simondh/RMAC-Arduino/README.md

# RMAC-Arduino
Remote Monitoring And Control

Old, obsolete Arduino C++ code.
Delete eventually?
