simondh/RMAC-Arduino/Mechanical/VW drawings/RMAC 1.3 3d.pdf

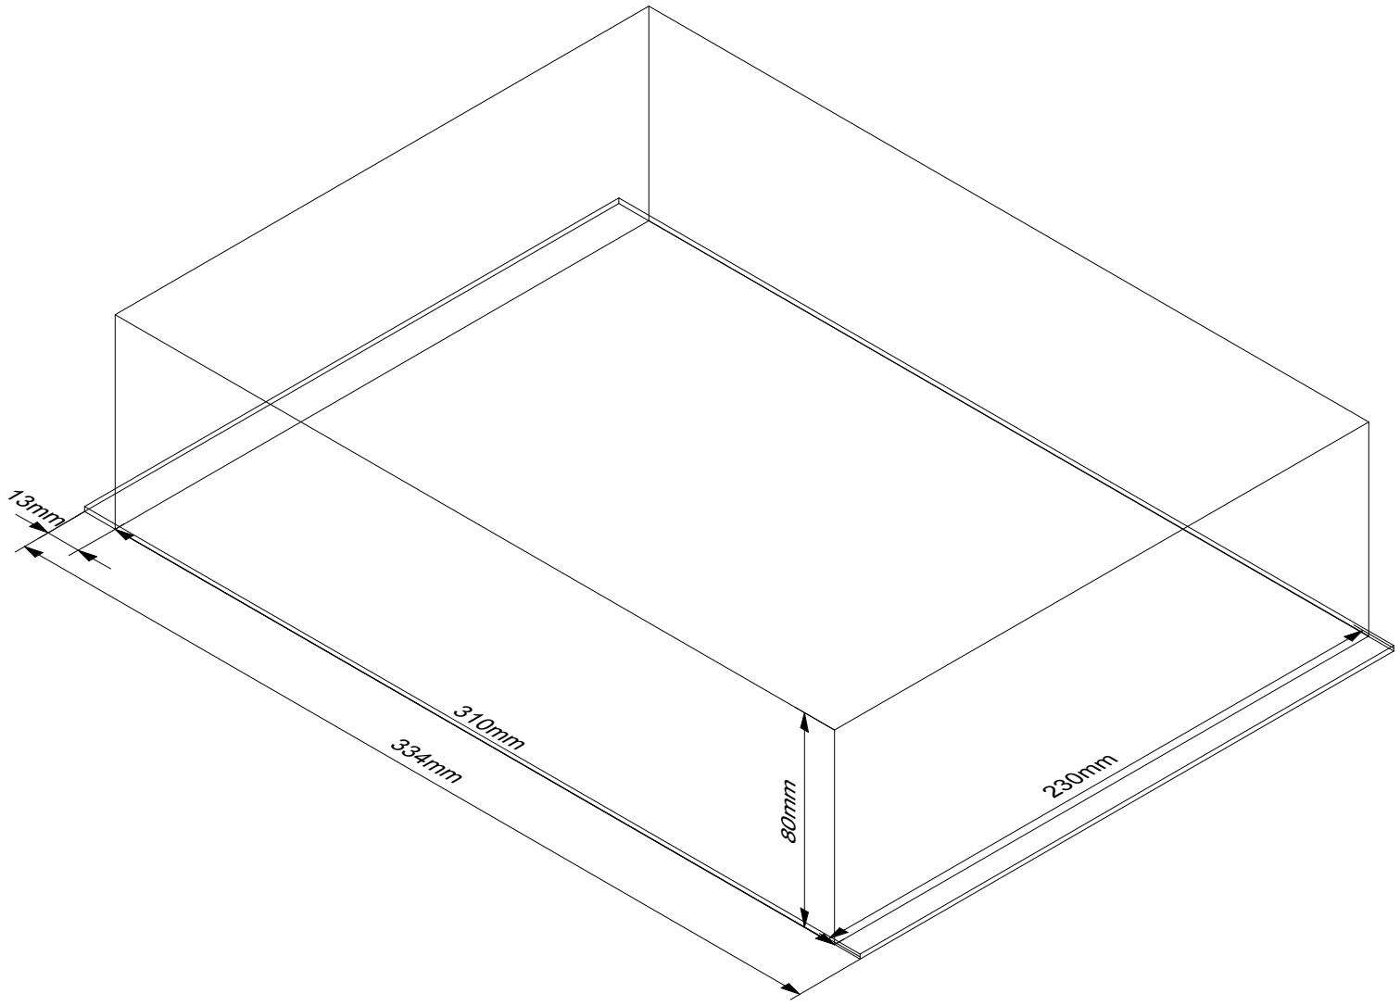
[picture p2: figure]
