simondh/RMAC-Arduino/Mechanical/partsList (from Simons MBP).xlsx

Sheet: Parts Ordered
Part | Currency | Amt | UKP | Supplier | link
Linkit One + relay shield |  |  | £161.93 | Cool Components | link
Relays, PIR, temp sensor, jumpers | US $ | $68.53 | £43.85 | Elecrow | link (http://www.elecrow.com/power-supply-c-68.html)
GSM cables | US $ |  |  | ChinaRF | link (http://www.ebay.com/usr/chinarf?_trksid=p2047675.l2559) | 4 u.fl - RP-SMA pigtails, 2 RP-SMA aerials, mag base
Cable glands |  |  |  | ? China
PSU 110v - 5v |  |  |  | RS
case, screws |  |  | £31.31 | RS

Sheet: parts list
Bill of Materials
Part # | Description | Eagle part no | Qty | Supplier | Supplier ref | Each | Total | Pack size | Unit cost | priced-each pack size | How many RMACs | Full description | Alternatiove
1 | Steel enclosure |  | 1 | RS | 232-002 | £22.73 | £22.73 | 1 | £22.73 |  |  | Grey 1.2mm mild steel case,310x230x80mm
1a | steel enclosure, alt |  | 1 | RS
2 | IEC socket |  | 1 | RS | 815-830 (http://uk.rs-online.com/web/p/iec-connectors/0815830/) | £2.18 | £2.18 | 1 | £2.18
2 | Fuse 1A slow blow 20X5mm |  | 2 | RS | 789-7797 | £0.11 | £0.22 | 1 | £0.22 |  |  | pack of 10
3 | IEC plug, free |  | 1 | RS | 488-905 | £2.27 | £2.27 | 1 | £2.27
4 | EDAC 38 cable receptacle |  | 1 | RS | 476-429 (http://uk.rs-online.com/web/p/general-purpose-rectangular-connectors/0476429/) | £6.40 | £6.40 | 1 | £6.40
5 | EDAC 38 plug |  | 1 | RS | 476-413 (http://uk.rs-online.com/web/p/general-purpose-rectangular-connectors/0476413/) | £9.73 | £9.73 | 1 | £9.73
6 | EDAC 38 cover |  | 1 | RS | 476-463 (http://uk.rs-online.com/web/p/backplane-accessories/0476463/) | £10.02 | £10.02 | 1 | £10.02
7 | EDAC solder terminals |  | 1 | RS | 476-485 | £22.88 | £22.88 | 1 | £22.88 |  |  | (Pack 100, will make 1.3 RMACs) | 476-491 crimp £17.83
8 | RP-SMA to mag base aerial, GSM |  | 1 | ChinaRF
 | u.fl to RP-SMA bulkhead |  | 1 | ChinaRF
8 | 0.1" pin headers 10 way |  | 1 | RS | 673-7486 | £0.24 | £0.24 | 1 | £0.24 | 5 | 5 | 26way IDC to Linkit
9 | 0.1" pin headers 8 way |  | 1 | RS | 132-0428 | £0.21 | £0.21 | 1 | £0.21 | 10 | 10 | 26way IDC to Linkit
10 | 0.1" pin headers 6 way |  | 3 | RS | 745-7062 | £0.18 | £0.54 | 1 | £0.54 | 10 | 3.333333333
 | 0.1" pin headers 6 way right0-angle |  | 1 | RS | 679-5473 | £0.10 | £0.10 | 1 | £0.10 | 10 | 10
11 | 0.1" pin headers 4 way | 4WAY3 | 1 | RS | 546-8899 | £12.80 | £12.80 | 1 | £12.80 | 10 | 10
12 | 0.1" pin headers 3 way |  | 1 | RS | 820-1431 | £0.10 | £0.10 | 1 | £0.10 | 5 | 5
12 | 0.1" pin headers 3 way | 3-WAY-1 | 1 | RS | 820-1431 | £0.10 | £0.10 | 1 | £0.10 | 5 | 5
13 | 26 way IDC plug | JP1 | 2 | RS | 471-064 | £0.66 | £1.32 | 1 | £1.32
14 | 26 way IDC socket |  | 2 | RS | 471-222 | £0.40 | £0.80 | 1 | £0.80
15 | 0.1" crimp sockets |  | 1 | RS | 467-598 | £6.00 | £6.00 | 1 | £6.00 |  |  | 100 per pack, 1 pack per RMAC
16 | 10W 5V dc, 2000mA |  | 1 | RS | 665-5710 | £37.50 | £37.50 | 1 | £37.50
17 | PCF8574A I2C 8-bit expander 0111,DIP16 |  | 2 | RS | 517-0249 | £1.33 | £2.66 | 1 | £2.66
18 | CNY74A quad optocoupler DIL 16 |  | 2 | RS | 699-8170 | £0.84 | £1.68 | 1 | £1.68 | 5 | 2.5
 | 15kΩ single R | R18, R20 | 2 | RS | 683-2737 (http://uk.rs-online.com/web/p/through-hole-fixed-resistors/6832737/) | £0.04 | £0.09 | 1 | £0.09 | 25 |  | RS don’t have any small low cost axial. Get in 1210?
 | 270kΩ | R22 | 1 | RS | 683-2799 | £0.06 | £0.06 | 1 | £0.06 | 25
 | 10kΩ 8 R bus (9 pin) | RN1 | 1 | RS | 788-4094 | £0.36 | £0.36 | 1 | £0.36 | 5 | 5
 | Isolated Resistor Array 10k½ ±2% 3 Resistors | RN5, RN6 | 2 | RS | 522-3602 | £0.07 | £0.14 | 1 | £0.14 | 25 | 12 | Try 691-7437 7 X 10kΩ SMD
 | Isolated Resistor Array 220½ ±2% 4 Resistors, SIP Package | RN4 | 1 | RS | 522-3882 | £0.04 | £0.04 | 1 | £0.04 | 25 | 25
 |  |  |  |  |  |  | £0.00 | 1 | £0.00
20 | Isolated Resistor Array 330Ω 4 Resistors, SIP Package | RN7, RN8 | 2 | RS | 522-3961 | £0.10 | £0.20 | 25 | £0.01 | 25 | 12
21 | Isolated Resistor Array 1kΩ 4 Resistors, SIP Package |  | 2 | RS | 522-3804 | £0.17 | £0.33 | 1 | £0.33 | 25 | 12
22 | Diode, Schottky Barrier 2A max, 60V, 2-Pin, DO-204AC |  | 2 | RS | 812-9326 | £0.13 | £0.27 | 1 | £0.27 | 20 | 10
23 | Zener diodes, 5.1V |  | 3 | RS | 708-7938 | £0.05 | £0.16 | 1 | £0.16 | 100 | 33.33333333
 | Modules
24 | RS485 daughter board |  | 1 | Elecrow |  |  | £0.00 |  | #DIV/0!
25 | Linkit One |  | 1 | Cool Components |  |  | £0.00 |  | #DIV/0!
25 | 4 relay board |  | 1 | Elecrow |  |  | £0.00 |  | #DIV/0!
25 | Temp & Humidity |  | 1 | Elecrow | EBR00081T | £3.19 |  | 1 | £3.19
26 | Finger Guard 60mm Steel |  | 1 | RS | 737-3973 | £0.84 | £0.84 | 1 | £0.84 | 10 | 10
27 | 0.1uf cap (100nf) |  | 6 | RS | 537-3707 | £0.15 | £0.88 | 1 | £0.88 | 25 | 4.166666667
28 | Equipment wire |  | - | RS | 361-721 | £17.29 | £0.35 | 1 | #VALUE! | 100m | 50
29 |  |  |  |  |  |  | £0.00 |  | #DIV/0!
30 | Front Panel: |  |  |  |  |  | £0.00 |  | #DIV/0!
31 | PIR |  | 1 | Elecrow | SOD00101S | £1.27 | £1.27 | 1 | £1.27
32 | LED Red |  | 1 | RS | 228-5988 |  | £0.07 | 1 | £0.00 | 5 | 5
33 | LED Green |  | 1 | RS | 646-6658 (http://uk.rs-online.com/web/p/visible-leds/6466658/) |  | £0.05 | 1 |  | 20 | 20
34 | LED Blue |  | 1 | RS | 466-3548 |  | £0.35 | 1 |  | 5 | 5
35
36 | Panels:
37 | Neutrik USB Panel Mount Socket |  | 1 | Maplin | N57FL | £5.29 | £5.29 | 1
38 | XLR Connector |  | 1 | RS | 455-104 | £1.27
39 | Male Straight Cable Mount XLR |  | 1 | RS | 455-122 | £1.95
 | M3 X 6 |  |  | RS | 560-580 | £2.05 |  |  |  | bag 100
 | M3 nylon nut |  |  | RS | 525-701 | £2.89 |  |  |  | bag 50
 | M3 self tap |  |  | RS | 483-1202 | £3.39 |  |  |  | bag 100 |  | Use for XLT socket!
 | M3 nylon washer |  |  | RS | 525-739 (http://uk.rs-online.com/web/p/sealing-washers/0525739/) | £1.63 |  |  |  | bag 50
 | M3 X M3 10mm nylon standoff |  |  | RS | 325-687 | £0.17 |  |  |  | bag 50
 | 10 way 7/0.15 PVC ribbon cable,10m |  |  | RS | 214-0661
 | stick on cable tie pads
 | tie wraps

Sheet: ConversionRate
GBP | US $ | 1.563

Sheet: Pins and design
Linkit One - logical |  |  |  |  |  |  |  |  |  |  | Linkit One - physical
Logical |  | Physical | Linkit use |  | DNO design use | Device | input/output | Alt | Main |  |  |  |  | Main | Alt
D0 | 8W-1-1 | 1 | Tx | Led | (Program uploader) |  | Input |  | N/A | 8w-2-1 | 19 | 18 | 10w-10 | D18 | SCL (NA)
D1 | 8W-1-2 | 2 | Rx | Led | (Program uploader) |  | Input |  | IOREF | 8w-2-2 | 20 | 17 | 10w-9 | D19 | SDA (NA)
D2 | 8W-1-3 | 3 | Eint |  | power fail |  | Input |  | RESET | 8w-2-3 | 21 | 16 | 10w-8 | N/A
D3 | 8W-1-4 | 4 | Eint / PWM |  | DigitalAlarm 1 |  |  |  | 3V3 | 8w-2-4 | 22 | 15 | 10w-7 | GND
D4 | 8W-1-5 | 5 |  |  | DigitalAlarm 2 |  | Input |  | 5V | 8w-2-5 | 23 | 14 | 10w-6 | D13 | (Internal LED)/spare
D5 | 8W-1-6 | 6 |  |  | DigitalAlarm 3 |  | Input |  | GND | 8w-2-6 | 24 | 13 | 10w-5 | D12 | 1WI Temperature
D6 | 8W-1-7 | 7 |  |  | DigitalAlarm 4 |  | Input |  | GND | 8w-2-7 | 25 | 12 | 10w-4 | D11 | PIR
D7 | 8W-1-8 | 8 |  |  | DigitalAlarm 5 |  | Input |  | N/A | 8w-2-8 | 26 | 11 | 10w-3 | D10 | DigitalAlarm 8
D8 | 10w-1 | 9 |  |  | DigitalAlarm 6 |  | Input | analog1 | ADC0 | 6w-1 | 27 | 10 | 10w-2 | D9 | DigitalAlarm 7
D9 | 10w-2 | 10 | PWM |  | DigitalAlarm 7 |  |  | analog2 | ADC1 | 6w-2 | 28 | 9 | 10w-1 | D8 | DigitalAlarm 6
D10 | 10w-3 | 11 |  |  | DigitalAlarm 8 |  | Input | analog3 | ADC2 | 6w-3 | 29 | 8 | 8w-1-8 | D7 | DigitalAlarm 5
D11 | 10w-4 | 12 | MOSI |  | PIR |  |  |  | ADC3 | 6w-4 | 30 | 7 | 8w-1-7 | D6 | DigitalAlarm 4
D12 | 10w-5 | 13 | MISO |  | 1WI for temp & humidity |  |  | SCL | D18 | 6w-5 | 31 | 6 | 8w-1-6 | D5 | DigitalAlarm 3
D13 | 10w-6 | 14 | SCK | Led |  |  |  | SDA | D19 | 6w-6 | 32 | 5 | 8w-1-5 | D4 | DigitalAlarm 2
 |  |  |  |  |  |  |  |  |  |  |  | 4 | 8w-1-4 | D3 | DigitalAlarm 1
 |  |  |  |  |  |  |  | PCF8574AN expander | GND |  | 4 Way 1-1 | 3 | 8w-1-3 | D2 | power fail
 |  |  |  |  |  |  |  |  | 5V |  | 4 Way 1-2 | 2 | 8w-1-2 | TX | D1
 |  |  |  |  |  |  |  |  | SDA |  | 4 Way 1-3 | 1 | 8w-1-1 | RX | D0
D18 | 10w-9 | 17 | SDA |  | Signal expander | PCF8574AN | I/O |  | SCL |  | 4 Way 1-4
D19 | 10w-10 | 18 | SCL |  | Signal expander | PCF8574AN | I/O
ADC0 | 6w-1-1 | 27 |  |  | 20 ma 1 |  | Input
ADC1 | 6w-1-2 | 28 |  |  | 20 ma 2 |  | Input
ADC2 | 6w-1-3 | 29 |  |  | 20 ma 3 |  | Input
GND |  | PWR 1 |  | USB | To Panel USB socket
5 |  | PWR 2 |  | GSM Aerial | To Panel aerial socket
 |  |  |  |  |  |  |  | MOTHERBOARD
4-way-1-1 | GND | PCF8574AN expander |  |  |  |  |  | Plug & Pin | Purpose | To | To (B-end) | route to (on motherboard)
4-way-1-2 | 5V
4-way-1-3 | SDA
4-way-1-4 | SCL
 |  |  |  |  |  |  |  | 4-way-3-1 | GND | Linkit 4-way-1 |  | gnd | 'Bottom' of board nearest LinkIt logo
PCF8574AN expander |  |  |  |  |  |  |  | 4-way-3-2 | 5V |  |  | 5v | Connects to PCF8574AN expander
Logical | Physical | Connector | Purpose |  |  |  |  | 4-way-3-3 | SDA |  |  | PCF 14
A0 | 1 |  | 0v |  |  |  |  | 4-way-3-4 | SCL |  |  | PCF 15
A1 | 2 |  | 0v
A2 | 3 |  | 0v |  |  |  |  | 6-way-2-1 | 0v | 6-way-5 relay board |  | gnd
P0 | 4 | 6-way-2-2 | Relay 1 |  |  |  |  | 6-way-2-2 | relay 1 |  |  | PCF 4 (P0)
P1 | 5 | 6-way-2-3 | Relay 2 |  |  |  |  | 6-way-2-3 | relay 2 |  |  | PCF 5 (P1)
P2 | 6 | 6-way-2-4 | Relay 3 |  |  |  |  | 6-way-2-4 | relay 3 |  |  | PCF 6 (p2)
P3 | 7 | 6-way-2-5 | Relay 4 |  |  |  |  | 6-way-2-5 | relay 4 |  |  | PCF 7 (P3)
GND | 8 |  | 0v |  |  |  |  | 6-way-2-6 | 5v |  |  | 5v
P4 | 9 | 6-way-3-3 | Fault LED (Red)
P5 | 10 | 6-way-3-5 | Green LED |  |  |  |  | 6-way-3-1 | 0v | Front Panel | PIR 3 |  | Also LED -ve (cathode)
P6 | 11 | 6-way-3-5 | Transmission OK LED (Blue) |  |  |  |  | 6-way-3-2 | PIR detect |  | PIR 2
P7 | 12 |  | spare |  |  |  |  | 6-way-3-3 | Red LED + |  |  | PCF9 (P4) | Anode (+ve) long wire
~INT | 13 |  | (output, ignore) |  |  |  |  | 6-way-3-4 | Green LED + |  |  | PCF10 (P5) | Cathode (-ve) short wire
SCL | 14 | 4-way-3-4 | SCL |  |  |  |  | 6-way-3-5 | Blue LED + |  |  | PCF11 (P6)
SDA | 15 | 4-way-3-3 | SDA |  |  |  |  | 6-way-3-6 | 5v |  | PIR 1
Vcc | 16 |  | 5V
 |  |  |  |  |  |  |  | 6-way-4-1 | ADC0 | Linkit 6-way-1 | 6w-1 | Analogue resistors
 |  |  |  |  |  |  |  | 6-way-4-2 | ADC1 |  | 6w-2
 |  |  |  |  |  |  |  | 6-way-4-3 | ADC2 |  | 6w-3
 |  |  |  |  |  |  |  | 6-way-4-4 | na |  | 6w-4
 |  |  |  |  |  |  |  | 6-way-4-5 | na
EDAC 38 way |  |  |  |  | Relay Board |  |  | 6-way-4-6 | na
Pin | Pin Code |  |  |  | Logical | Physical | Connector
1 | A | Relay 1 NC | screw-1 |  | 0v | 6-way-5-1 | mother 0v | 3-way-1 | gnd | Temp & Humidity
2 | B | Relay 1 common | screw-2 |  | relay 1 | 6-way-5-2 | PCF pin 4 | 3-way-2 | 5v
3 | C | relay 1 NO | screw-3 |  | relay 2 | 6-way-5-3 | PCF pin 5 | 3-way-3 | sig |  |  | 10way1-5
4 | D | Relay 2 NC | screw-4 |  | relay 3 | 6-way-5-4 | PCF pin 6
5 | E | Relay 2 common | screw-5 |  | relay 4 | 6-way-5-5 | PCF pin 7 | 10-way-2-1 | DigitalAlarm 6 | Linkit 10-way | CNY74-2-14
6 | F | relay 2 NO | screw-6 |  | 5V | 6-way-5-6 | mother 5v | 10-way-2-2 | DigitalAlarm 7 |  | CNY74-2-11
7 | H | Relay 3 NC | screw-7 |  | Relay 1 NC | screw-1 | EDAC A | 10-way-2-3 | DigitalAlarm 8 |  | CNY74-2-10
8 | J | Relay 3 common | screw-8 |  | Relay 1 common | screw-2 | EDAC B | 10-way-2-4 | PIR |  | 6-way-3-2
9 | K | relay 3 NO | screw-9 |  | relay 1 NO | screw-3 | EDAC C | 10-way-2-5 | 1WI Temperature |  | 3-way-3
10 | L | Relay 4 NC | screw-10 |  | Relay 2 NC | screw-4 | EDAC D | 10-way-2-6 | D13 |  | RS485 driver
11 | M | Relay 4 common | screw-11 |  | Relay 2 common | screw-5 | EDAC E | 10-way-2-7 | na
12 | N | relay 4 NO | screw-12 |  | relay 2 NO | screw-6 | EDAC F | 10-way-2-8 | na
13 | P | (spare) |  |  | Relay 3 NC | screw-7 | EDAC H | 10-way-2-9 | na
14 | R | (spare) |  |  | Relay 3 common | screw-8 | EDAC J | 10-way-2-10 | na
15 | S | (spare) |  |  | relay 3 NO | screw-9 | EDAC K
16 | T | (spare) |  |  | Relay 4 NC | screw-10 | EDAC L | 8-way-7-1 | na | Linkit 8-way-1
17 | U | DigAlarm 1 A | 1 |  | Relay 4 common | screw-11 | EDAC M | 8-way-7-2 | na
18 | V | DigAlarm 1 B | 2 |  | relay 4 NO | screw-12 | EDAC N | 8-way-7-3 | power fail |  |  | PSU before diodes
19 | W | DigAlarm 2 A | 3 |  |  |  |  | 8-way-7-4 | DigitalAlarm1 |  | CNY74-1-15
20 | X | DigAlarm 2 B | 4 |  |  |  |  | 8-way-7-5 | DigitalAlarm2 |  | CNY74-1-14
21 | Y | DigAlarm 3 A | 5 |  |  |  |  | 8-way-7-6 | DigitalAlarm3 |  | CNY74-1-11
22 | Z | DigAlarm 3 B | 6 |  |  |  |  | 8-way-7-7 | DigitalAlarm4 |  | CNY74-1-10
23 | AA | DigAlarm 4 A | 7 |  |  |  |  | 8-way-7-8 | DigitalAlarm5 |  | CNY74-2-15
24 | BB | DigAlarm 4 B | 8
25 | CC | DigAlarm 5 A | 9 |  |  |  |  | 26-w-1 | DigAlarm 1 A | U | CNY74 resistors | +5v B
26 | DD | DigAlarm 5 B | 10 |  |  |  |  | 26-w-2 | DigAlarm 1 B | V |  | 330Ω R9 | CNY74-1-1
27 | EE | DigAlarm 6 A | 11 |  |  |  |  | 26-w-3 | DigAlarm 2 A | W |  | +5v B
28 | FF | DigAlarm 6 B | 12 |  |  |  |  | 26-w-4 | DigAlarm 2 B | X |  | 330Ω R10 | CNY74-1-4
29 | HH | DigAlarm 7 A | 13 |  |  |  |  | 26-w-5 | DigAlarm 3 A | Y |  | +5v B
30 | JJ | DigAlarm 7 B | 14 |  |  |  |  | 26-w-6 | DigAlarm 3 B | Z |  | 330Ω R11 | CNY74-1-5
31 | KK | DigAlarm 8 A | 15 |  |  |  |  | 26-w-7 | DigAlarm 4 A | AA |  | +5v B
32 | LL | DigAlarm 8 B | 16 |  |  |  |  | 26-w-8 | DigAlarm 4 B | BB |  | 330Ω R12 | CNY74-1-8
33 | MM | Analog 1 0v | 17 |  |  |  |  | 26-w-9 | DigAlarm 5 A | CC |  | +5v B
34 | NN | Analog 1 12v | 18 |  |  |  |  | 26-w-10 | DigAlarm 5 B | DD |  | 330Ω R13 | CNY74-2-1
35 | PP | Analog 2 0v | 19
36 | RR | Analog 2 12v | 20 |  |  |  |  | 26-w-11 | DigAlarm 6 A | EE |  | +5v B
37 | SS | Analog 3 0v | 21 |  |  |  |  | 26-w-12 | DigAlarm 6 B | FF |  | 330Ω R14 | CNY74-2-4
38 | TT | Analog 3 12v | 22 |  |  |  |  | 26-w-13 | DigAlarm 7 A | HH |  | +5v B
Yes the letters are NOT in sequence! |  |  |  |  |  |  |  | 26-w-14 | DigAlarm 7 B | JJ |  | 330Ω R15 | CNY74-2-5
 |  |  |  |  |  |  |  | 26-w-15 | DigAlarm 8 A | KK |  | +5v B
 |  |  |  |  |  |  |  | 26-w-16 | DigAlarm 8 B | LL |  | 330Ω R16 | CNY74-2-8
 |  |  |  |  |  |  |  | 26-w-17 | Analog 1 0v | MM | Dividing resistors | GND
Socket Summary |  |  |  |  |  |  |  | 26-w-18 | Analog 1 12v | NN |  | 14kΩ R20
Motherboard | Other end |  |  |  |  |  |  | 26-w-19 | Analog 2 0v | PP |  | GND
2-way-1 | Mains input |  |  |  |  |  |  | 26-w-20 | Analog 2 12v | RR |  | 14kΩ R18
2-way-2 | RS485
3-way-1 | Temp & Humidity |  |  |  |  |  |  | 26-w-21 | Analog 3 0v | SS | Dividing resistors | GND
6-way-2 | Relay board |  |  |  |  |  |  | 26-w-22 | Analog 3 110v | TT |  | 270kΩ R22
6-way-3 | Front cover |  |  |  |  |  |  | 26-w-23 | spare | P
6-way-4 | LinkIt 6-way |  |  |  |  |  |  | 26-w-24 | spare | R
4-way-1 | Linkit SCL/SDA 4-way |  |  |  |  |  |  | 26-w-25 | spare | S
8-way-1 | Linkit 8-way-1 |  |  |  |  |  |  | 26-w-26 | spare | T
10-way-1 | Linkit 10-way
26-way | EDAC 38 way
 | Point sizes for drawing cables
 | 3 | 2.25
 | 4 | 3
 | 5 | 3.75
 | 6 | 4.5
 | 8 | 6
 | 10 | 7.5
 | 12 | 9

Sheet: Pin Design V2
Linkit One - logical |  |  |  |  |  |  |  |  |  |  |  | Linkit One - physical
Logical |  | Physical | Linkit use |  | DNO design use | Device | input/output | Alt |  | Main |  |  |  |  | Main | Alt
D0 | 8W-1-1 | 1 | Tx | Led | (Program uploader) |  | Input |  |  | N/A | 8w-2-1 | 19 | 18 | 10w-10 | D18 | SCL (NA)
D1 | 8W-1-2 | 2 | Rx | Led | (Program uploader) |  | Input |  |  | IOREF | 8w-2-2 | 20 | 17 | 10w-9 | D19 | SDA (NA)
D2 | 8W-1-3 | 3 | Eint |  | power fail |  | Input |  |  | RESET | 8w-2-3 | 21 | 16 | 10w-8 | N/A
D3 | 8W-1-4 | 4 | Eint / PWM |  | DigitalAlarm 1 |  |  |  |  | 3V3 | 8w-2-4 | 22 | 15 | 10w-7 | GND
D4 | 8W-1-5 | 5 |  |  | DigitalAlarm 2 |  | Input |  |  | 5V | 8w-2-5 | 23 | 14 | 10w-6 | D13 | (Internal LED)/spare
D5 | 8W-1-6 | 6 |  |  | DigitalAlarm 3 |  | Input |  |  | GND | 8w-2-6 | 24 | 13 | 10w-5 | D12 | 1WI Temperature
D6 | 8W-1-7 | 7 |  |  | DigitalAlarm 4 |  | Input |  |  | GND | 8w-2-7 | 25 | 12 | 10w-4 | D11 | PIR
D7 | 8W-1-8 | 8 |  |  | DigitalAlarm 5 |  | Input |  |  | N/A | 8w-2-8 | 26 | 11 | 10w-3 | D10 | self test (Active LOW - tun on pull up R!)
D8 | 10w-1 | 9 |  |  | DigitalAlarm 6 |  | Input | analog1 |  | ADC0 | 6w-1 | 27 | 10 | 10w-2 | D9
D9 | 10w-2 | 10 | PWM |  | DigitalAlarm 7 |  |  | analog2 |  | ADC1 | 6w-2 | 28 | 9 | 10w-1 | D8
D10 | 10w-3 | 11 |  |  | DigitalAlarm 8 |  | Input | analog3 |  | ADC2 | 6w-3 | 29 | 8 | 8w-1-8 | D7
D11 | 10w-4 | 12 | MOSI |  | PIR |  |  |  |  | ADC3 | 6w-4 | 30 | 7 | 8w-1-7 | D6 | RS485 RO
D12 | 10w-5 | 13 | MISO |  | 1WI for temp & humidity |  |  | SCL |  | D18 | 6w-5 | 31 | 6 | 8w-1-6 | D5 | RS485 DI
D13 | 10w-6 | 14 | SCK | Led |  |  |  | SDA |  | D19 | 6w-6 | 32 | 5 | 8w-1-5 | D4 | RS485 DE
 |  |  |  |  |  |  |  |  |  |  |  |  | 4 | 8w-1-4 | D3 | RS485 RE
 |  |  |  |  |  |  |  | PCF8574AN expander |  | GND |  | 4 Way 1-1 | 3 | 8w-1-3 | D2 | power fail
 |  |  |  |  |  |  |  |  |  | 5V |  | 4 Way 1-2 | 2 | 8w-1-2 | TX | D1
 |  |  |  |  |  |  |  |  |  | SDA |  | 4 Way 1-3 | 1 | 8w-1-1 | RX | D0
D18 | 10w-9 | 17 | SDA |  | Signal expander | PCF8574AN | I/O |  |  | SCL |  | 4 Way 1-4
D19 | 10w-10 | 18 | SCL |  | Signal expander | PCF8574AN | I/O
ADC0 | 6w-1-1 | 27 |  |  | 20 ma 1 |  | Input
ADC1 | 6w-1-2 | 28 |  |  | 20 ma 2 |  | Input
ADC2 | 6w-1-3 | 29 |  |  | 20 ma 3 |  | Input
GND |  | PWR 1 |  | USB | To Panel USB socket
5 |  | PWR 2 |  | GSM Aerial | To Panel aerial socket
 |  |  |  |  |  |  |  | MOTHERBOARD
4-way-1-1 | GND | PCF8574AN expander |  |  |  |  |  | Plug & Pin | Other End | Purpose | To | To (B-end) | route to (on motherboard)
4-way-1-2 | 5V
4-way-1-3 | SDA
4-way-1-4 | SCL
 |  |  |  |  |  |  |  | 4-way-3-1 |  | GND | Linkit 4-way-1 |  | gnd | 'Bottom' of board nearest LinkIt logo
PCF8574AN expander |  |  |  |  |  |  |  | 4-way-3-2 |  | 5V |  |  | 5v | Connects to PCF8574AN expander
Logical | Physical | Connector | Purpose |  |  |  |  | 4-way-3-3 |  | SDA |  |  | PCF 14
A0 | 1 |  | 0v |  |  |  |  | 4-way-3-4 |  | SCL |  |  | PCF 15
A1 | 2 |  | 0v
A2 | 3 |  | 0v |  |  |  |  | 6-way-2-1 | relay 6-1 | 0v | 6-way-5 relay board |  | gnd
P0 | 4 | 6-way-2-2 | Relay 1 |  |  |  |  | 6-way-2-2 | relay 6-2 | relay 1 |  |  | PCF 4 (P0)
P1 | 5 | 6-way-2-3 | Relay 2 |  |  |  |  | 6-way-2-3 | relay 6-3 | relay 2 |  |  | PCF 5 (P1)
P2 | 6 | 6-way-2-4 | Relay 3 |  |  |  |  | 6-way-2-4 | relay 6-4 | relay 3 |  |  | PCF 6 (p2)
P3 | 7 | 6-way-2-5 | Relay 4 |  |  |  |  | 6-way-2-5 | relay 6-5 | relay 4 |  |  | PCF 7 (P3)
GND | 8 |  | 0v |  |  |  |  | 6-way-2-6 | relay 6-6 | 5v |  |  | 5v
P4 | 9 | 6-way-3-3 | Fault LED (Red)
P5 | 10 | 6-way-3-5 | Green LED |  |  |  |  | 6-way-3-1 | Front 6-1 | 0v | Front Panel | PIR 3 |  | Also LED -ve (cathode)
P6 | 11 | 6-way-3-5 | Transmission OK LED (Blue) |  |  |  |  | 6-way-3-2 | Front 6-2 | PIR detect |  | PIR 2
P7 | 12 |  | spare |  |  |  |  | 6-way-3-3 | Front 6-3 | Red LED + |  |  | PCF9 (P4) | Anode (+ve) long wire
~INT | 13 |  | (output, ignore) |  |  |  |  | 6-way-3-4 | Front 6-4 | Green LED + |  |  | PCF10 (P5) | Cathode (-ve) short wire
SCL | 14 | 4-way-3-4 | SCL |  |  |  |  | 6-way-3-5 | Front 6-5 | Blue LED + |  |  | PCF11 (P6)
SDA | 15 | 4-way-3-3 | SDA |  |  |  |  | 6-way-3-6 | Front 6-6 | 5v |  | PIR 1
Vcc | 16 |  | 5V
 |  |  |  |  |  |  |  | 26-w-2-19 | LinkIt 6-1 | ADC0 | Linkit 6-way-1 | 6w-1 | Analogue resistors
 |  |  |  |  |  |  |  | 26-w-2-20 | LinkIt 6-2 | ADC1 |  | 6w-2
 |  |  |  |  |  |  |  | 26-w-2-21 | LinkIt 6-3 | ADC2 |  | 6w-3
 |  |  |  |  |  |  |  | 26-w-2-22 | LinkIt 6-4 | na |  | 6w-4
 |  |  |  |  |  |  |  | 26-w-2-23 | LinkIt 6-5 | na
EDAC 38 way |  |  |  |  | Relay Board |  |  | 26-w-2-24 | LinkIt 6-6 | na
Pin | Pin Code |  |  |  | Logical | Physical | Connector
1 | A |  | screw-1 |  | 0v | 6-way-5-1 | mother 0v | 3-way-1 |  | gnd | Temp & Humidity
2 | B | Relay 1 common | screw-2 |  | relay 1 | 6-way-5-2 | PCF pin 4 | 3-way-2 |  | 5v
3 | C | relay 1 NO | screw-3 |  | relay 2 | 6-way-5-3 | PCF pin 5 | 3-way-3 |  | sig |  |  | 10way1-5
4 | D | Relay 2 NC | screw-4 |  | relay 3 | 6-way-5-4 | PCF pin 6
5 | E | Relay 2 common | screw-5 |  | relay 4 | 6-way-5-5 | PCF pin 7 | 26-w-2-1 | Linkit 10-1 |  | Linkit 10-way
6 | F | relay 2 NO | screw-6 |  | 5V | 6-way-5-6 | mother 5v | 26-w-2-2 | Linkit 10-2
7 | H | Relay 3 NC | screw-7 |  | Relay 1 NC | screw-1 | EDAC A | 26-w-2-3 | Linkit 10-3 | self test | D10 | active LOW, turn on pull-up R
8 | J | Relay 3 common | screw-8 |  | Relay 1 common | screw-2 | EDAC B | 26-w-2-4 | Linkit 10-4 | PIR |  | 6-way-3-2
9 | K | relay 3 NO | screw-9 |  | relay 1 NO | screw-3 | EDAC C | 26-w-2-5 | Linkit 10-5 | 1WI Temperature |  | 3-way-3
10 | L | Relay 4 NC | screw-10 |  | Relay 2 NC | screw-4 | EDAC D | 26-w-2-6 | Linkit 10-6 | D13 |  | RS485 driver
11 | M | Relay 4 common | screw-11 |  | Relay 2 common | screw-5 | EDAC E | 26-w-2-7 | Linkit 10-7 | na
12 | N | relay 4 NO | screw-12 |  | relay 2 NO | screw-6 | EDAC F | 26-w-2-8 | Linkit 10-8 | na
13 | P | (spare) |  |  | Relay 3 NC | screw-7 | EDAC H | 26-w-2-9 | Linkit 10-9 | na
14 | R | (spare) |  |  | Relay 3 common | screw-8 | EDAC J | 26-w-2-10 | Linkit 10-10 | na
15 | S | (spare) |  |  | relay 3 NO | screw-9 | EDAC K
16 | T | (spare) |  |  | Relay 4 NC | screw-10 | EDAC L | 26-w-2-11 | Linkit 8-1-1 | na | Linkit 8-way-1
17 | U | DigAlarm 1 A | 1 |  | Relay 4 common | screw-11 | EDAC M | 26-w-2-12 | Linkit 8-1-2 | na
18 | V | DigAlarm 1 B | 2 |  | relay 4 NO | screw-12 | EDAC N | 26-w-2-13 | Linkit 8-1-3 | power fail |  |  | PSU before diodes
19 | W | DigAlarm 2 A | 3 |  |  |  |  | 26-w-2-14 | Linkit 8-1-4 | RS485 RE |  |  | swapped for routing
20 | X | DigAlarm 2 B | 4 |  |  |  |  | 26-w-2-15 | Linkit 8-1-5 | RS485 DE
21 | Y | DigAlarm 3 A | 5 |  |  |  |  | 26-w-2-16 | Linkit 8-1-6 | RS485 DI
22 | Z | DigAlarm 3 B | 6 |  |  |  |  | 26-w-2-17 | Linkit 8-1-7 | RS485 RO
23 | AA | DigAlarm 4 A | 7 |  |  |  |  | 26-w-2-18 | Linkit 8-1-8
24 | BB | DigAlarm 4 B | 8
25 | CC | DigAlarm 5 A | 9 |  |  |  |  | 26-w-1-1 | EDAC | DigAlarm 1 A | U | CNY74 resistors | +5v B
26 | DD | DigAlarm 5 B | 10 |  |  |  |  | 26-w-1-2 |  | DigAlarm 1 B | V |  | 330Ω R9 | CNY74-1-1
27 | EE | DigAlarm 6 A | 11 |  |  |  |  | 26-w-1-3 |  | DigAlarm 2 A | W |  | +5v B
28 | FF | DigAlarm 6 B | 12 |  |  |  |  | 26-w-1-4 |  | DigAlarm 2 B | X |  | 330Ω R10 | CNY74-1-4
29 | HH | DigAlarm 7 A | 13 |  |  |  |  | 26-w-1-5 |  | DigAlarm 3 A | Y |  | +5v B
30 | JJ | DigAlarm 7 B | 14 |  |  |  |  | 26-w-1-6 |  | DigAlarm 3 B | Z |  | 330Ω R11 | CNY74-1-5
31 | KK | DigAlarm 8 A | 15 |  |  |  |  | 26-w-1-7 |  | DigAlarm 4 A | AA |  | +5v B
32 | LL | DigAlarm 8 B | 16 |  |  |  |  | 26-w-1-8 |  | DigAlarm 4 B | BB |  | 330Ω R12 | CNY74-1-8
33 | MM | Analog 1 0v | 17 |  |  |  |  | 26-w-1-9 |  | DigAlarm 5 A | CC |  | +5v B
34 | NN | Analog 1 12v | 18 |  |  |  |  | 26-w-1-10 |  | DigAlarm 5 B | DD |  | 330Ω R13 | CNY74-2-1
35 | PP | Analog 2 0v | 19
36 | RR | Analog 2 12v | 20 |  |  |  |  | 26-w-1-11 |  | DigAlarm 6 A | EE |  | +5v B
37 | SS | Analog 3 0v | 21 |  |  |  |  | 26-w-1-12 |  | DigAlarm 6 B | FF |  | 330Ω R14 | CNY74-2-4
38 | TT | Analog 3 12v | 22 |  |  |  |  | 26-w-1-13 |  | DigAlarm 7 A | HH |  | +5v B
Yes the letters are NOT in sequence! |  |  |  |  |  |  |  | 26-w-1-14 |  | DigAlarm 7 B | JJ |  | 330Ω R15 | CNY74-2-5
 |  |  |  |  |  |  |  | 26-w-1-15 |  | DigAlarm 8 A | KK |  | +5v B
 |  |  |  |  |  |  |  | 26-w-1-16 |  | DigAlarm 8 B | LL |  | 330Ω R16 | CNY74-2-8
 |  |  |  |  |  |  |  | 26-w-1-17 |  | Analog 1 0v | MM | Dividing resistors | GND
Socket Summary |  |  |  |  |  |  |  | 26-w-1-18 |  | Analog 1 12v | NN |  | 14kΩ R20
Motherboard | Other end |  |  |  |  |  |  | 26-w-1-19 |  | Analog 2 0v | PP |  | GND
2-way-1 | Mains input |  |  |  |  |  |  | 26-w-1-20 |  | Analog 2 12v | RR |  | 14kΩ R18
2-way-2 | RS485 |  |  |  |  |  |  | 26-w-1-21 |  | Analog 3 0v | SS | Dividing resistors | GND
3-way-1 | Temp & Humidity |  |  |  |  |  |  | 26-w-1-22 |  | Analog 3 110v | TT |  | 270kΩ R22
6-way-2 | Relay board |  |  |  |  |  |  | 26-w-1-23 |  | spare | P
6-way-3 | Front cover |  |  |  |  |  |  | 26-w-1-24 |  | spare | R
6-way-4 | LinkIt 6-way |  |  |  |  |  |  | 26-w-1-25 |  | spare | S | self test
4-way-1 | Linkit SCL/SDA 4-way |  |  |  |  |  |  | 26-w-1-26 |  | spare | T | self test
8-way-1 | Linkit 8-way-1
10-way-1 | Linkit 10-way
26-way | EDAC 38 way
 | Point sizes for drawing cables
 | 3 | 2.25
 | 4 | 3
 | 5 | 3.75
 | 6 | 4.5
 | 8 | 6
 | 10 | 7.5
 | 12 | 9

Sheet: Pin Design V1.2
PCB V1.2.0 | 2015-01-26
New in this version:
Second PCF8574A-2 now reads ALL 8 no-volt relay contacts
RS485 borad included, and uses 4 LinkIt digital pins
self-test contact on EDAC and jumper pins on board.
This End |  | Other End
Pin | Function | Board / Function | Pin | Function
EDAC
A | relay 1 NC | Relay board | screw-1
B | Relay 1 common |  | screw-2
C | relay 1 NO |  | screw-3
D | Relay 2 NC |  | screw-4
E | Relay 2 common |  | screw-5
F | relay 2 NO |  | screw-6
H | Relay 3 NC |  | screw-7
J | Relay 3 common |  | screw-8
K | relay 3 NO |  | screw-9
L | Relay 4 NC |  | screw-10
M | Relay 4 common |  | screw-11
N | relay 4 NO |  | screw-12
P | RS485 A | RMAC JP1 | 1
R | RS485 B |  | 2
S | Self Test A |  | 3
T | Self Test B |  | 4
U | DigAlarm 1 A |  | 5
V | DigAlarm 1 B |  | 6
W | DigAlarm 2 A |  | 7
X | DigAlarm 2 B |  | 8
Y | DigAlarm 3 A |  | 9
Z | DigAlarm 3 B |  | 10
AA | DigAlarm 4 A |  | 11
BB | DigAlarm 4 B |  | 12
CC | DigAlarm 5 A |  | 13
DD | DigAlarm 5 B |  | 14
EE | DigAlarm 6 A |  | 15
FF | DigAlarm 6 B |  | 16
HH | DigAlarm 7 A |  | 17
JJ | DigAlarm 7 B |  | 18
KK | DigAlarm 8 A |  | 19
LL | DigAlarm 8 B |  | 20
MM | Analog 1 0v |  | 21
NN | Analog 1 12v |  | 22
PP | Analog 2 0v |  | 23
RR | Analog 2 12v |  | 24
SS | Analog 3 0v |  | 25
TT | Analog 3 140v |  | 26
Relay Board
1 | GND | RMAC 6way2 | 1 |  | IC4 PCF8574A-1 | pin
2 | relay 1 |  | 2 | RELAYBUS3 | P0 | 4
3 | relay 2 |  | 3 | RELAYBUS2 | P1 | 5
4 | relay 3 |  | 4 | REALYBUS1 | P2 | 6
5 | relay 4 |  | 5 | RELAYBUS0 | P3 | 7
6 | +5V |  | 6
4 X relays, NO, Common, NC to EDAC direct wiring, see EDAC table
EDAC A -> N
RMAC board
JP1 EDAC connector - see EDAC table. 26pin IDC, 1-1 mapping to EDAC pins
JP2 | RS485 | MAX485 board A & B signal pins
1 | A
2 | B
JP3 | Mains input - 240V AC or 110 V DC
A | N/0v
B | L / 110V
JP4 - Linkit connector, 26 way IDC (connects to 10-way, 8-way & 6-way on Linkit)
 |  | LimkIT pin | LinkIT func | Function |  | other
1 | na | 10w-1 | D8
2 | na | 10w-2 | D9
3 | self test . | 10w-3 | D10 | Jumper on board + EDAC S + T
4 | PIR | 10w-4 | D11 | to 6W3-2 front panel conector
5 | Temp & Humidity | 10w-5 | D12 | to 3W1-3, to temp unit. 1WI |  | ANALOGBUS3
6 | na | 10w-6 | D13
7 | na | 10w-7 | D14
8 | na | 10w-8 | na
9 | na | 10w-9 | SDA | not used from here
10 | na | 10w-10 | SCL
11 | na | 8w1-1 | Tx, D0 | Program upload, don't use
12 | na | 8w1-2 | Rx, D1 | Program upload, don't use
13 | na | 8w1-3 | D2 | power fail | +5V via 10kΩ
14 | RS485 | 8w1-4 | D3 | RS485 RE | TO MAX485 board
15 | RS485 | 8w1-5 | D4 | RS486 DE | TO MAX485 board
16 | RS485 | 8w1-6 | D5 | RS487 DI | TO MAX485 board
17 | RS485 | 8w1-7 | D6 | RS488 RO | TO MAX485 board
18 | na | 8w1-8 | D7
19 | Analogue 0 | 6w-1 | ADC0 | ANALOGBUS0
20 | Analogue 1 | 6w-2 | ADC1 | ANALOGBUS1
21 | Analogue 2 | 6w-3 | ADC2 | ANALOGBUS2
22 | na | 6w-4 | ADC3 | na
23 | na | 6w-5 | SCL | do not use
24 | na | 6w-6 | SDA | do not use
25 | na
26 | na
JP5 | Self test
1 | gnd
2 | self test | Link pins to start self-test
3-way-1 | temperature and humidity sensor, uses 1-wire-interface
1 | GND
2 | +5V
3 | 1WI | ANALOGBUS3 | JP4-5, to Linkit 10W-5, D12
4WAY3 | SDA/SCL to Linkit, uses deicated 4-way on Linkit board
1 | GND | (same pins on Linkit)
2 | +5V
3 | SDA | 10kΩ pull up to +5V
4 | SCL | 10kΩ pull up to +5V
6WAY2 | To relay board,
1 | GND | RMAC 6way2 | 1 |  | IC4 PCF8574A-1 | pin
2 | relay 1 |  | 2 | RELAYBUS3 | P0 | 4
3 | relay 2 |  | 3 | RELAYBUS2 | P1 | 5
4 | relay 3 |  | 4 | REALYBUS1 | P2 | 6
5 | relay 4 |  | 5 | RELAYBUS0 | P3 | 7
6 | +5V |  | 6
6WAY3 | Front Cover
1 | GND
2 | PIR | high for movement detected (?)
3 | Blue LED | IC4 PCF8574A | P6 | Pin 11
4 | Red LED |  | P5 | Pin 10
5 | Green LED |  | P4 | Pin 9
6 | +5V
LINKIT
Uses 10 way, one of two * way, 6way and 4way SDA/SCL
10W-1 | na | D8
10W-2 | na | D9
10W-3 | self test . | D10
10W-4 | PIR | D11
10W-5 | Temp & Humidity | D12
10W-6 | na | D13
10W-7 | na | D14
10W-8 | na | na
10W-9 | na | SDA
10W-10 | na | SCL
8w1-1 | na | Tx, D0
8w1-2 | na | Rx, D1
8w1-3 | na | D2
8w1-4 | RS485 | D3
8w1-5 | RS485 | D4
8w1-6 | RS485 | D5
8w1-7 | RS485 | D6
8w1-8 | na | D7
6w-1 | Analogue 0 | 6w-1 | ADC0
6w-2 | Analogue 1 | 6w-2 | ADC1
6w-3 | Analogue 2 | 6w-3 | ADC2
6w-4 | na | 6w-4 | ADC3
6w-5 | na | 6w-5 | SCL
6w-6 | na | 6w-6 | SDA
4w-1 | GND | (same pins on RMAC |  | Note these connect to 2 X PCF8574A expanders
4w-2 | +5V |  |  | IC4 Outputs - 4 X Relay, 3 X LEDs. Address 3 LSB 000
4w-3 | SDA | 10kΩ pull up to +5V |  | IC5 all inputs, digital alarms 0-7. Address LSB 001
4w-4 | SCL | 10kΩ pull up to +5V
GSM Aerial | Under board, minatuire co-ax
USB | To USB panel socket, for programming and monitoring
power - dunno yet.
