simondh/RMAC-Arduino/Mechanical/VW drawings/RMAC 1.3 enclosure.pdf

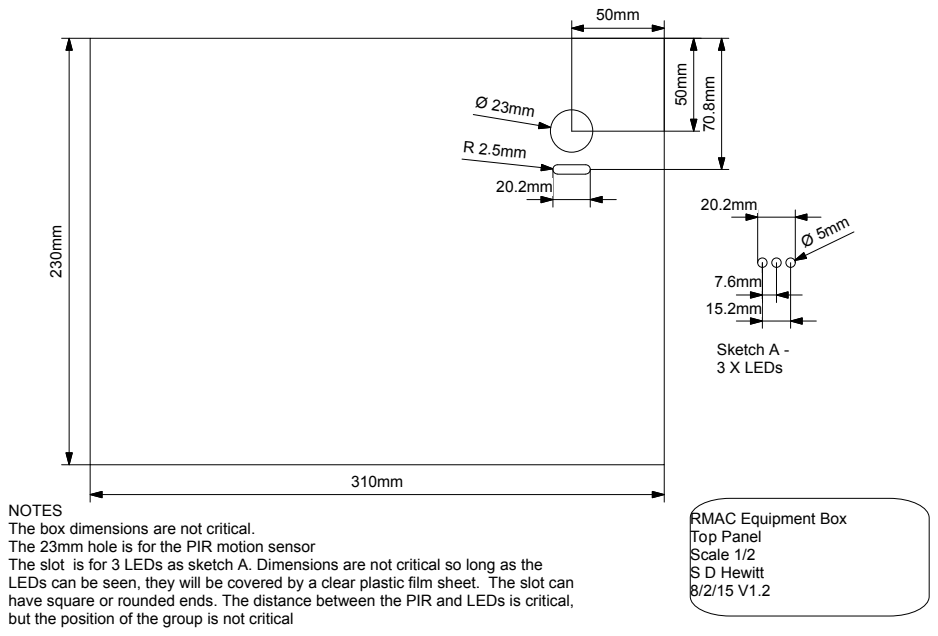
[picture p3: page 1]
RMAC Equipment Box Top Panel Scale 1/2 S D Hewitt 8/2/15 V1.2; Sketch A - 3 X LEDs

NOTES
The box dimensions are not critical.
The 23mm hole is for the PIR motion sensor
The slot is for 3 LEDs as sketch A. Dimensions are not critical so long as the
LEDs can be seen, they will be covered by a clear plastic film sheet. The slot can
have square or rounded ends. The distance between the PIR and LEDs is critical,
but the position of the group is not critical

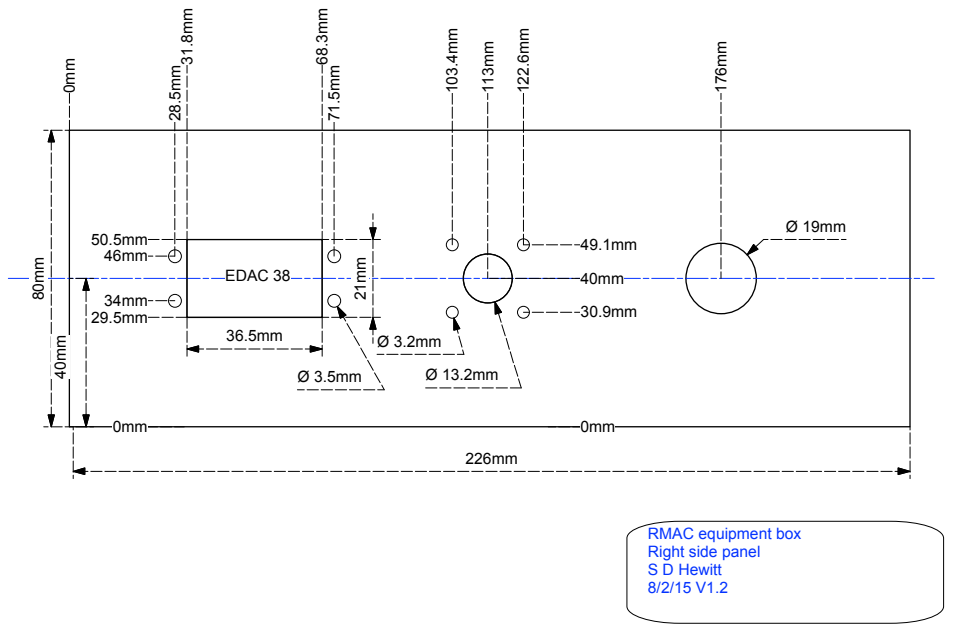
[picture p4: page 2]
EDAC 38

RMAC equipment box
Right side panel
S D Hewitt

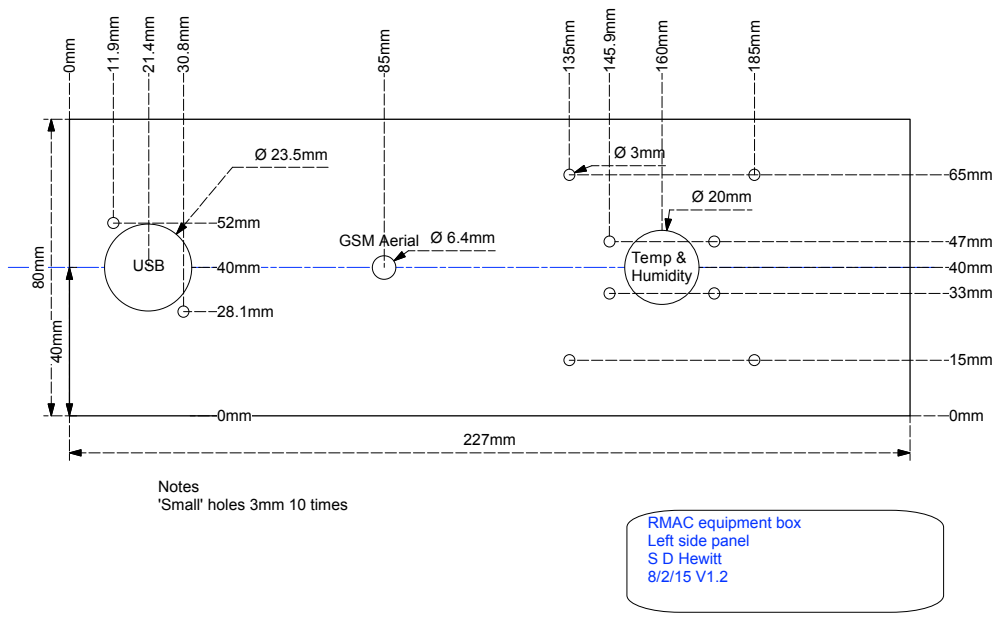
[picture p5: page 3]
USB; Temp &; Humidity; GSM Aerial

Notes
'Small' holes 3mm 10 times

RMAC equipment box
Left side panel
S D Hewitt
