simondh/RMAC-Arduino/RMAC Eagle/Board 2.pdf

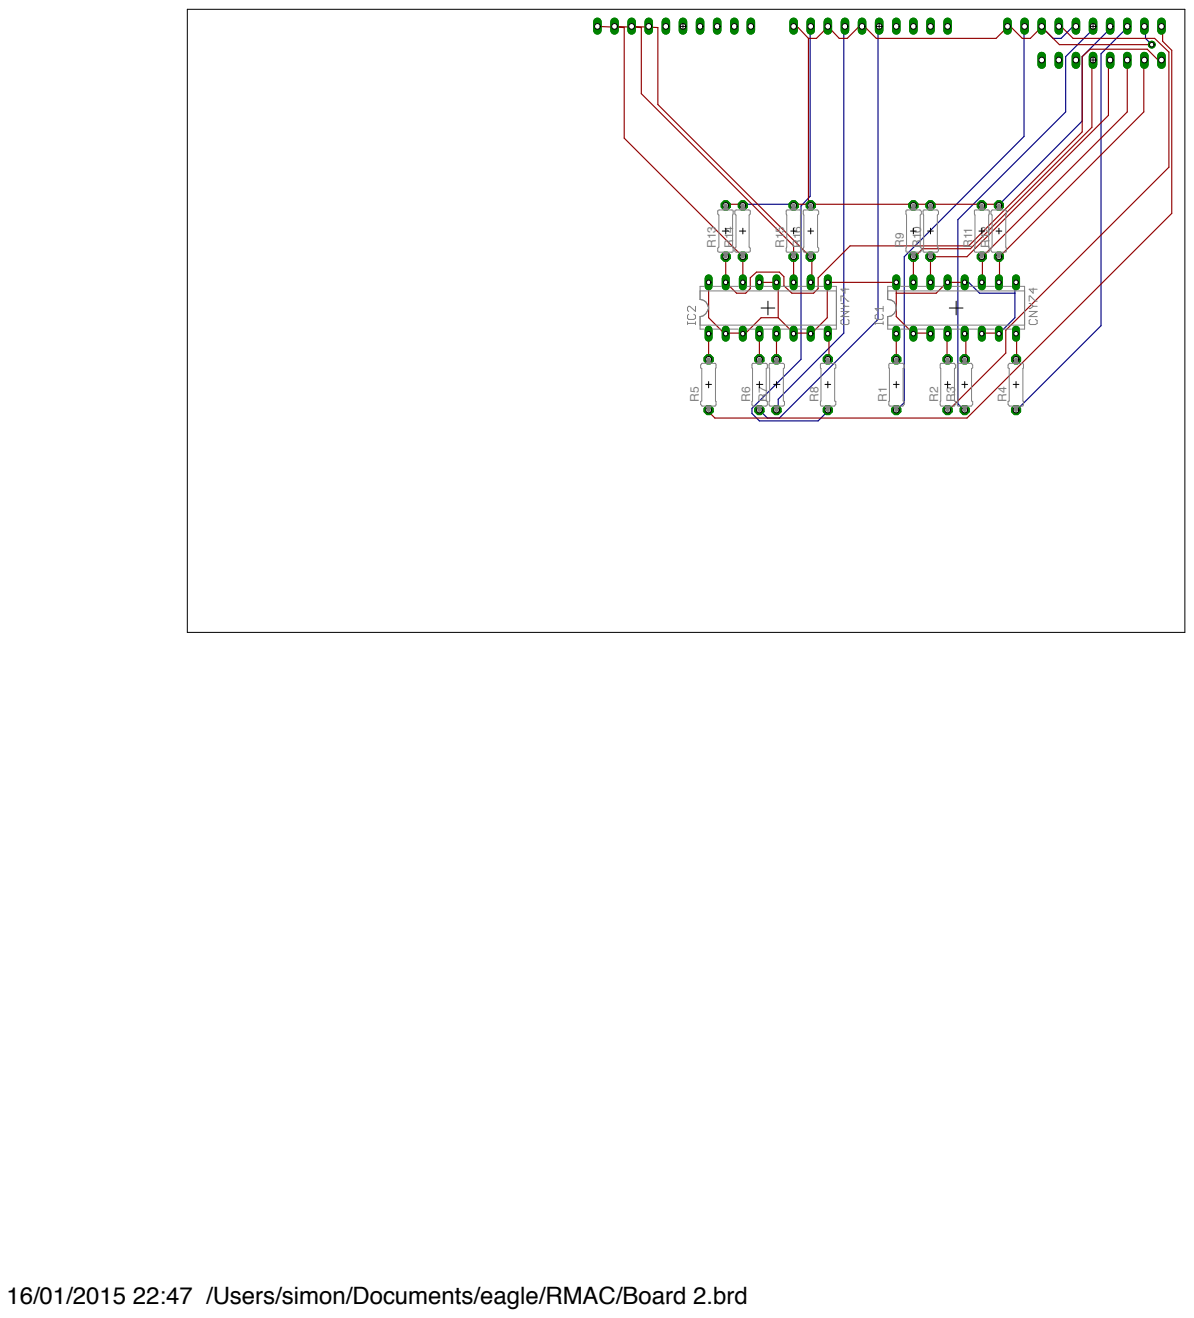
[picture p6: page 1]

16/01/2015 22:47 /Users/simon/Documents/eagle/RMAC/Board 2.brd
