simondh/RMAC-Arduino/Mechanical/VW drawings/RMAC 1.3 right panel.pdf

EDAC 38

RMAC equipment box
Right side panel
S D Hewitt
