simondh/RMAC-Arduino/RMAC Eagle/Board 2.brd

## EAGLE design RMAC Eagle/Board 2.brd (2015-04-07)

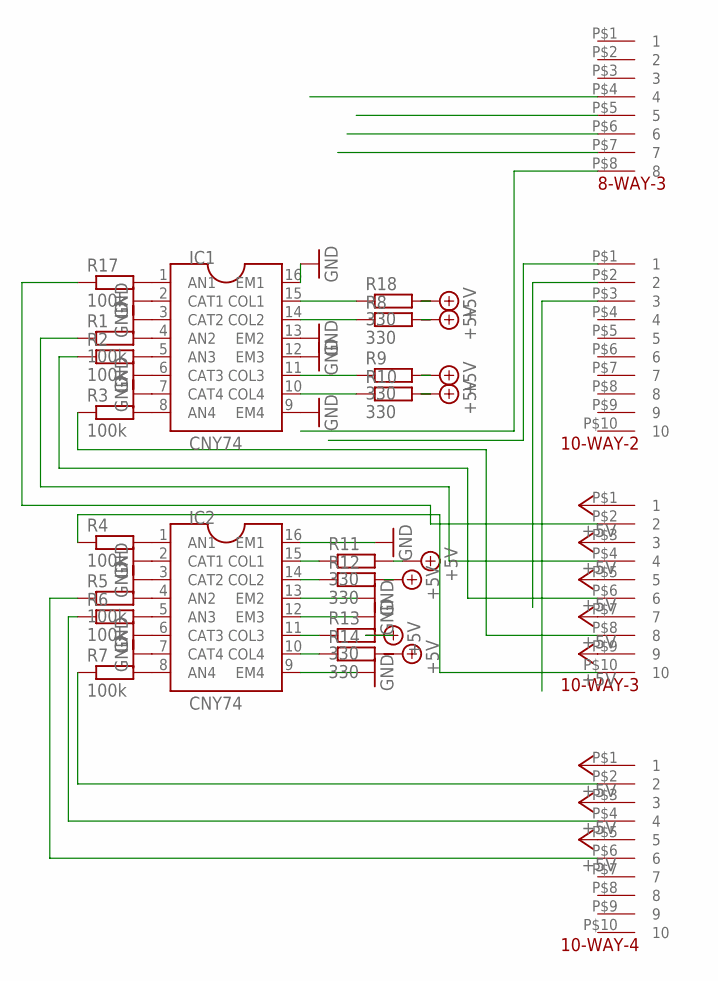
[picture p7: schematic Board 2.sch]

Parts:
8-WAY-3: SDH8PIN
10-WAY-2, 10-WAY-3, 10-WAY-4: SDH10PIN
IC1, IC2: IC-CNY74-16DIL
R1, R2, R3, R4, R5, R6, R7, R17: 100k; P0613V
R8, R9, R10, R11, R12, R13, R14, R18: 330; P0613V

Connections:
+5V: 10-WAY-3.P$1 (1), 10-WAY-3.P$3 (3), 10-WAY-3.P$5 (5), 10-WAY-3.P$7 (7), 10-WAY-3.P$9 (9), 10-WAY-4.P$1 (1), 10-WAY-4.P$3 (3), 10-WAY-4.P$5 (5), R8.2, R9.2, R10.2, R11.2, R12.2, R13.2, R18.2
GND: IC1.2 (CAT1), IC1.3 (CAT2), IC1.6 (CAT3), IC1.7 (CAT4), IC1.9 (EM4), IC1.12 (EM3), IC1.13 (EM2), IC1.16 (EM1), IC2.2 (CAT1), IC2.3 (CAT2), IC2.6 (CAT3), IC2.7 (CAT4), IC2.9 (EM4), IC2.12 (EM3), IC2.13 (EM2), IC2.16 (EM1)
unnamed: IC1.1 (AN1), R17.2
unnamed: IC1.4 (AN2), R1.2
unnamed: IC1.5 (AN3), R2.2
unnamed: IC1.8 (AN4), R3.2
unnamed: IC2.1 (AN1), R4.2
unnamed: IC2.4 (AN2), R5.2
unnamed: IC2.5 (AN3), R6.2
unnamed: IC2.8 (AN4), R7.2
unnamed: 10-WAY-3.P$8 (8), R3.1
unnamed: 10-WAY-3.P$6 (6), R2.1
unnamed: 10-WAY-3.P$4 (4), R1.1
unnamed: 10-WAY-3.P$2 (2), R17.1
unnamed: 10-WAY-3.P$10 (10), R4.1
unnamed: 10-WAY-4.P$2 (2), R7.1
unnamed: 10-WAY-4.P$4 (4), R6.1
unnamed: 10-WAY-4.P$6 (6), R5.1
unnamed: IC1.14 (COL2), R8.1
unnamed: IC1.11 (COL3), R9.1
unnamed: IC1.10 (COL4), R10.1
unnamed: IC1.15 (COL1), R18.1
unnamed: IC2.14 (COL2), R12.1
unnamed: IC2.15 (COL1), R11.1
unnamed: IC2.11 (COL3), R13.1
unnamed: IC2.10 (COL4), R14.1

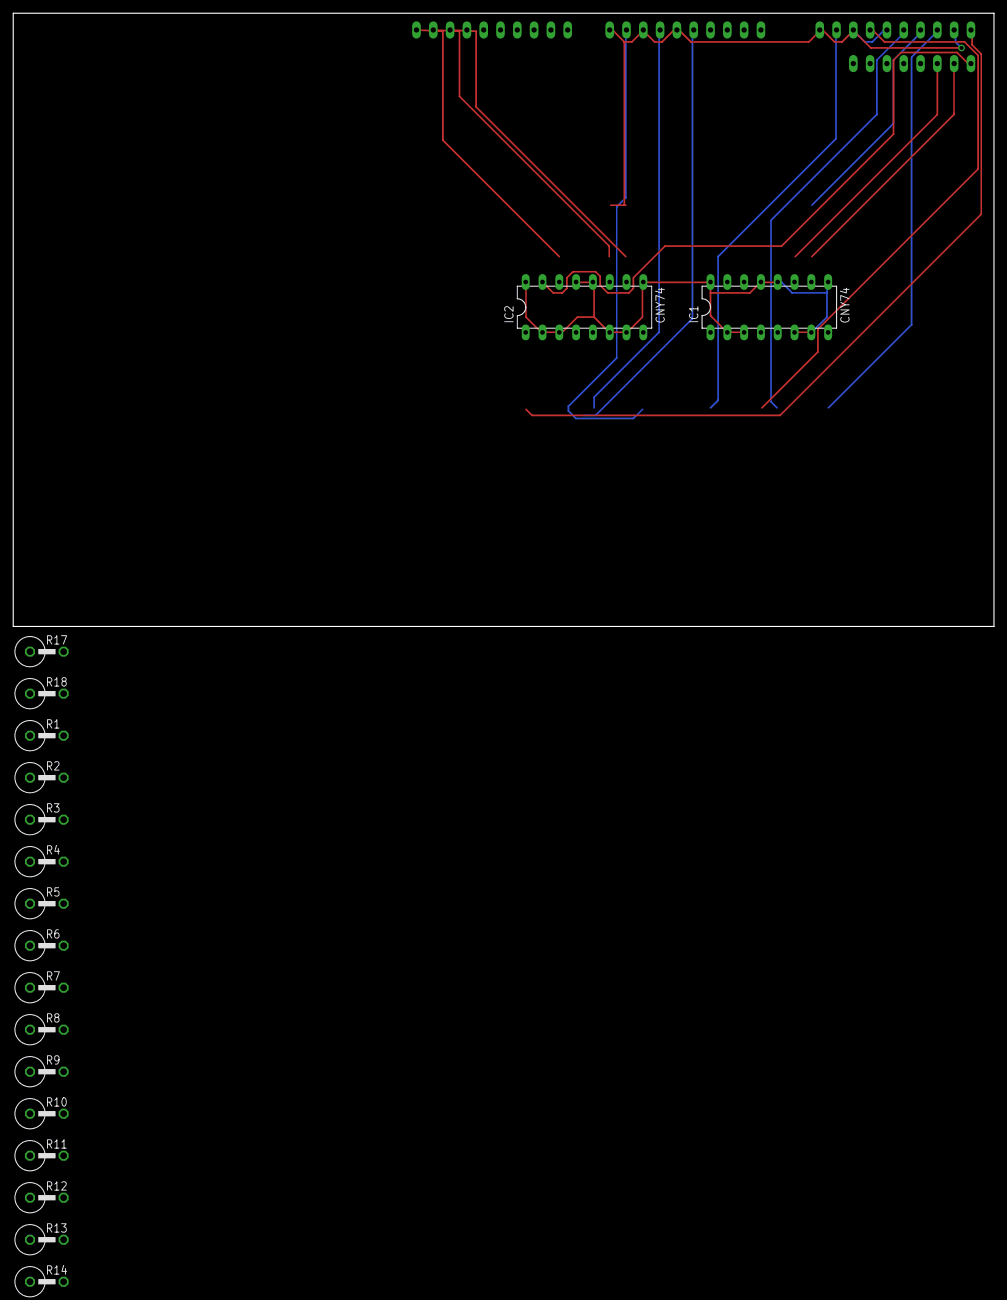
[picture p8: board Board 2.brd from above]

Board: 2 copper layers, 148.3 x 92.7 mm, 22 parts (0 on the bottom side), 26 nets.
