simondh/RMAC-Arduino/RMAC Eagle/board 1.brd

## EAGLE design RMAC Eagle/board 1.brd (2015-04-07)

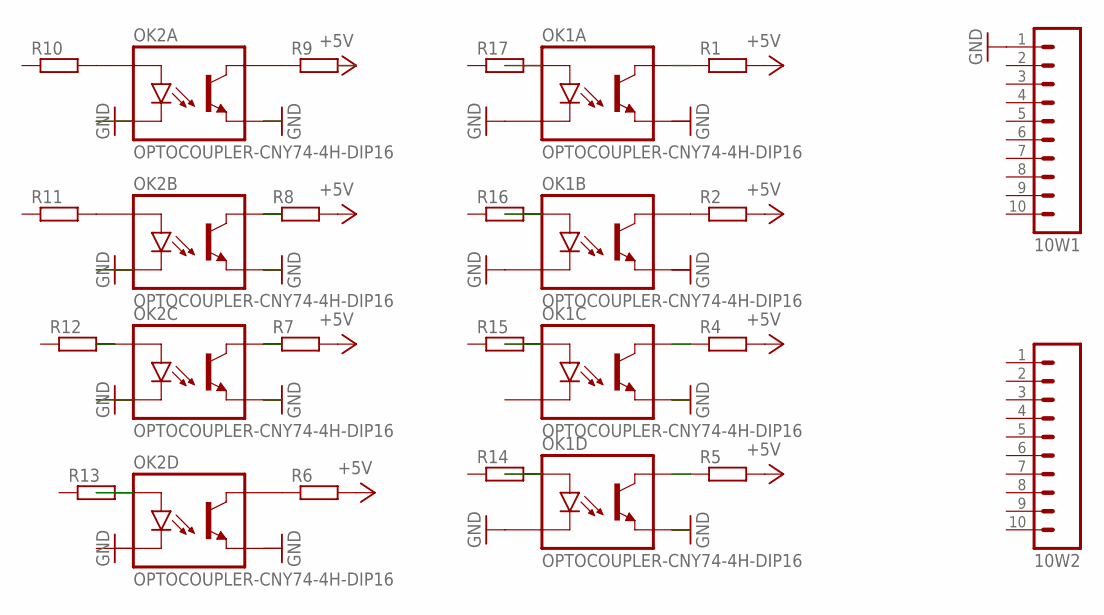
[picture p9: schematic board 1.sch]

Parts:
10W1, 10W2: M10; 10P
OK1, OK2: OPTOCOUPLER-CNY74-4H-DIP16; DIL16-3
R1, R2, R4, R5, R6, R7, R8, R9, R10, R11, R12, R13, R14, R15, R16, R17: R-EU_0207/7; 0207/7

Connections:
+5V: R1.2, R2.2, R4.2, R5.2, R6.2, R7.2, R8.2, R9.2
ALM3: OK1.4 (A1), R16.2
ALM4: OK1.1 (A1), R17.2
GND: 10W1.1, OK1.2 (C1), OK1.3 (C1), OK1.7 (C1), OK1.10 (EMITTER1), OK1.12 (EMITTER1), OK2.2 (C1), OK2.3 (C1), OK2.6 (C1), OK2.12 (EMITTER1), OK2.13 (EMITTER1), OK2.16 (EMITTER1)
unnamed: OK1.15 (COLLECTOR1), R1.1
unnamed: OK2.14 (COLLECTOR1), R8.1
unnamed: OK1.11 (COLLECTOR1), R4.1
unnamed: OK1.9 (COLLECTOR1), R5.1
unnamed: OK2.9 (COLLECTOR1), R6.1
unnamed: OK2.4 (A1), R11.2
unnamed: OK2.5 (A1), R12.2
unnamed: OK2.8 (A1), R13.2
unnamed: OK1.8 (A1), R14.2
unnamed: OK1.5 (A1), R15.2
unnamed: OK1.14 (COLLECTOR1), R2.1
unnamed: OK2.1 (A1), R10.2
unnamed: OK2.15 (COLLECTOR1), R9.1
unnamed: OK2.11 (COLLECTOR1), R7.1

Board: 2 copper layers, 20 parts (1 on the bottom side), 18 nets, no tracks yet.
