simondh/RMAC-Arduino/DNOCR_Rmac.h

//
//  DNOCR_Rmac.h
//  DNOCR_LIB
//
//  Created by Simon Hewitt on 07/01/2015.
//  Copyright (c) 2015 Simon Hewitt. All rights reserved.
//
//  This is the DNOC Remote Monitoring main library.
//  It contains classes that define the main entities such as unit, alarm, securityEntities
//  and general utilities
//  Note the code is intended for the LinkitOne development board, a dialect of Arduino
//  and can only be compiled on an Arduino IDE with the Linkit One extension.
//
//  Contact simon@whd-engineering.com
//

#ifndef __DNOCR_LIB__DNOCR_Rmac__
#define __DNOCR_LIB__DNOCR_Rmac__

#include "LFlash.h"

// define XCODE to dev and test under XCODE, standard C++. Comment out for normal Arduino use
#define XCODE 1

class DNOCR_Config;


/*
 ** class Site
 ** There should be only one, as it defines the entire site 
 ** (but see long StackOverflow discussion on singletons , decided not to use singleton, just don't define it twice!)
 ** Contains all site wide data, and methods to serrialize /userialize to/from Flash file.
*/

class Site
{
public:
    // Methods
    Site(); // constructor
    
    // constants
 
    enum SecurityLevels {sec_None, sec_RO, sec_Low, sec_High, sec_Admin, sec_ALL};

// TODO: I don't need these, they are set by unarchive or message processing.
//    const char * getSiteID() const;
//    int setSiteID(const char*);
//    const char * getSiteShortName()const ;
//    int setSiteShortName(const char*);
//    const char * getSiteLongName()const ;
//    int setSiteLongName(const char*);
//    const char * getLowSecurityPIN()const ;
//    int setLowSecurityPIN(const char*) ;
//    const char * getHighSecurityPIN()const ;
//    int setHighSecurityPIN(const char*);
    void archive (DNOCR_Config *saveObj);
    void unarchive (DNOCR_Config *restoreObj);
    bool pinOK (char *pin, SecurityLevels securityLevel);
    
    
    // Public attributes
    bool configDirty = 0;        // set to 1 on any config change, reset to 0 when saved to config file
    bool debugON = true;        // set to false for no debug
    int  logFileNumber = 0;     // Simple incrementing number to suffix log files
    static int logFileDay;      // new log is created on startup and on day change. This is day of year used for that
    datetimeInfo bootupTime;    // actually time the object created

private:
    char siteID[IDLength];              // any string to ID the site
    char siteShortName[ShortNameLength];// short names for SMS use
    char siteLongName[LongNameLength];  // long name for later Web use
    char lowSecurityPIN[PINlength+1];      // low security PIN. Not to be confused with a phyiscal electrical PIN
    char highSecurityPIN[PINlength+1];      // low security PIN. Not to be confused with a phyiscal electrical PIN
    
};

class DigitalAlarm
{
    
private:
    int alarmNumber;        // 1..8. Constructor inits to 0, which marks it unused.
    char alarmID[IDLength];
    char alarmName[LongNameLength];
    bool active;            // Is this alarm actually in use??
    int digitalPin;         // The LinkIt Pin number for the signal
    bool alarmOnOpen;       // if true, alarm raised on open-circuit == HIGH(?), false alarm on closed circuit == LOW
    bool silence;               // if TRUE, do not send alarms
    int retransmitMinutes;      // retransmit any alarms this many minutes
    ardTime lastTransmitted;    // Time alarm was last sent
    bool alarmed;               // true if in alarm now
    ardTime alarmRaisedTime;
    ardTime alarmClearedTime;
    //ardTime lastSentTime;
    int sessionAlarmCount;      // since startup (in Site object)
    long globalAlarmCount;      // saved in config files, count since factory reset
    int deBounce;               // How many intervals must alarm be active before it is certain
    int bounceCount;            // count up to deBounce
    int checkInterval;          // milliseconds eg 500 to check 2 per second
    unsigned long lastChecked;           // global millis value when last checked.
    
    // private methods
    void sendDigitalAlarm(const char *typeOfAlarm);
    
public:
    
    DigitalAlarm(int alarmNum);  // constructor, does not do much !
    void archive (DNOCR_Config *saveObj);
    void unarchive (DNOCR_Config *restoreObj, const int restoreAlarmNum);
    bool isActive();
    void setupAlarm();
    void checkAlarm (Site *site);
    
};


class AuthorisedUsers
{
public:
    int userNumber; // 1..32
    bool active;
    char userName[LongNameLength];
    char phone[MaxPhoneLength];
    Site::SecurityLevels securityLevel;

    AuthorisedUsers(const int unum);
    void archive (DNOCR_Config *saveObj);
    void unarchive (DNOCR_Config *restoreObj, const int restoreAlarmNum);
};



#endif /* defined(__DNOCR_LIB__DNOCR_Rmac__) */
