simondh/RMAC-Arduino/(commit log)

2015-01-17 Added layout & parts list (and .gitignore)
    [partsList.xlsx]
2015-04-07 just bringing to tidy state
    [Board 2.brd, Board 2.sch, board 1.brd, board 1.sch, partsList (from Simons MBP).xlsx, partsList.xlsx]
